MrGaintsquirrel/amplifier/versterker.kicad_pcb

## KiCad design versterker.kicad_pcb (2022-01-10)

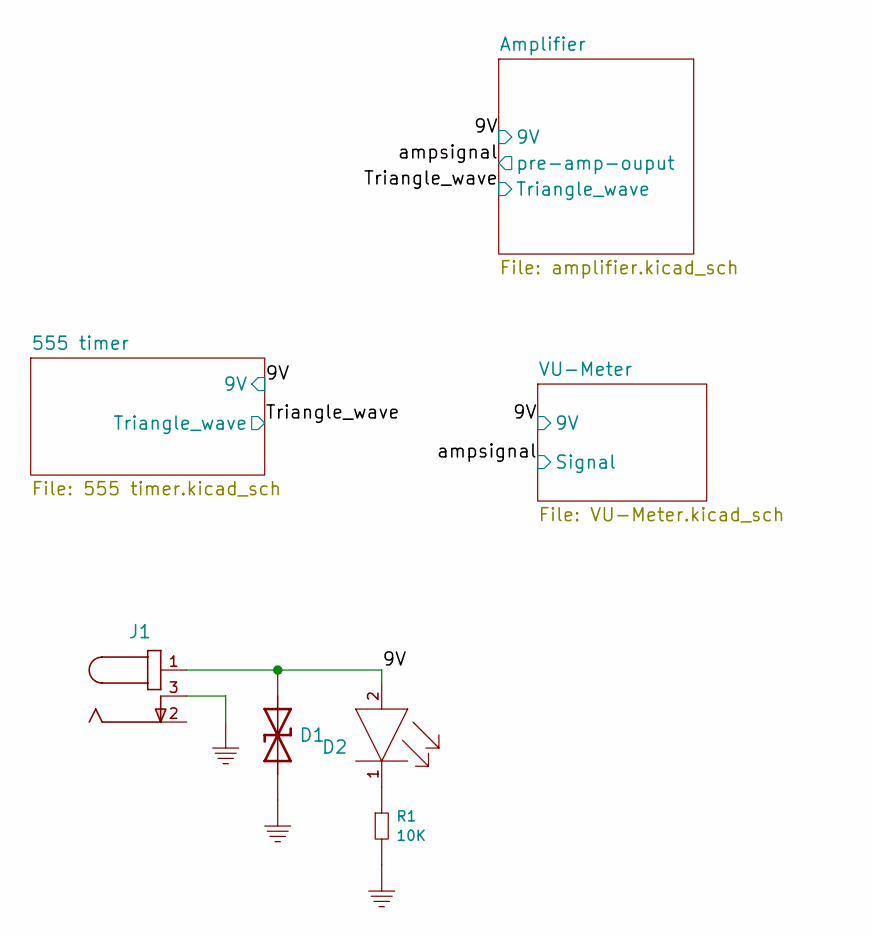
[picture p1: schematic versterker.kicad_sch]

Parts:
D1: D_SMCJ9.0CA_TVS; D_9V_TVS_SMCJ-Q; PARTREV 11/20/15; Mouser 576-SMCJ9.0CA
D2: D_RED_0603_Wurth_150060RS75000; D_RED_0603_Wurth; Mouser 710-150060RS75000
J1: J_Barreljack_3.5mm_Wurth_TH; J_Barreljack_3.5mm_Wurth; Mouser 710-694102303002
R1: R_10K_0603; R_0603; Mouser 667-ERJ-UP3F1002V

Connections:
/9V: D1.1, D2.2 (ANODE), J1.1; also elsewhere on the board
GND: D1.2, J1.3, R1.2; also elsewhere on the board
unnamed: D2.1 (CATHODE), R1.1

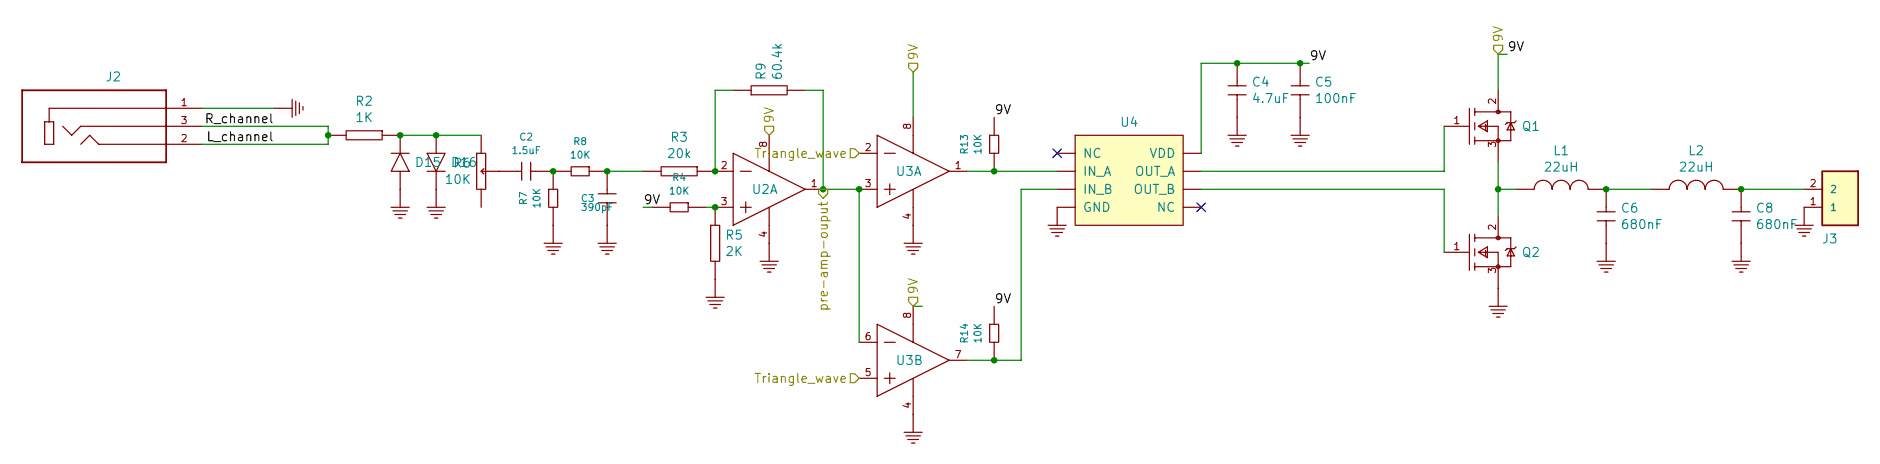
[picture p2: schematic amplifier.kicad_sch]

Parts:
C2: C_1.5uF_0603_25V; C_0603; Mouser 810-C1608X5R1E155K
C3: C_390pF_0603_50V; C_0603; Mouser 80-C0603C391K5R
C4: C_4.7uF_0603_25V; C_0603; Mouser 963-TMK107BBJ475KA-T
C5: C_100nF_0603_25V; C_0603; Mouser 810-C0603X5R1E104KBB
C6, C8: C_680nF_TH_450V; C_ECWFD_Panasonic; Mouser 667-ECW-FD2W684J
D15, D16: D_1N4148WS_SOD323F_ONSEMI; D_1N4148_SOD-323F_ONSEMI; Mouser 512-1N4148WS
J2: J_3.5mm_jack_SJ1-3523N; CUI_SJ1-3523N; Mouser 490-SJ1-3523N
J3: J_2_screwterminal_2.54_282834-2; J_2_screwterminal_2.54; Mouser 571-282834-2
L1, L2: L_22uH_RFS1113_coilcraft_TH; L_RFS1113_coilcraft; Mouser 994-RFS1113-223ME
Q1, Q2: Q_IRFZ44NPBF_N-Channel_Infineon; Q_IRFZ44NPBF_Infineon; Mouser 942-IRFZ44NPBF
R2: R_1K_0603; R_0603; Mouser 667-ERJ-PB3D1001V
R3: R_20K_0603; R_0603; Mouser 603-RT0603FRE0720KL
R4, R7, R8, R13, R14: R_10K_0603; R_0603; Mouser 667-ERJ-UP3F1002V
R5: R_2K_0603; R_0603; Mouser 603-RT0603BRD072KL
R6: R_10K_Potmeter; R_TH_POT_P160series
R9: R_60.4K_0603; R_0603; Mouser 603-RT0603DRE0760K4L
U2: U_LM358AP_TI_DIP; Mouser 926-LM358N/NOPB
U3: U_LM393N_NOPB; U_TI_LM393N_NOPB; Mouser 926-LM393N/NOPB
U4: U_TC4427M_Microchip; U_8_DIP_TC4427CPA_Microchip; Mouser 579-TC4427ACPA

Connections:
/9V: C4.1, C5.1, Q1.2 (DRAIN), R4.2, R13.1, R14.1, U2.8 (VCC), U3.8 (V+), U4.6 (VDD); also elsewhere on the board
/Amplifier/L_channel: J2.2, J2.3, R2.2
/Triangle_wave: U3.2 (INA-), U3.5 (INB+); also elsewhere on the board
/ampsignal: R9.2, U2.1 (1OUT), U3.3 (INA+), U3.6 (INB-); also elsewhere on the board
GND: C3.2, C4.2, C5.2, C6.2, C8.2, D15.A, D16.C, J2.1, J3.1, Q2.3 (SOURCE), R5.2, R7.2, U2.4 (GND), U3.4 (GND), U4.3 (GND); also elsewhere on the board
unnamed: C2.1, R7.1, R8.2
unnamed: C2.2, R6.2 (S)
unnamed: C3.1, R3.2, R8.1
unnamed: C6.1, L1.2, L2.1
unnamed: C8.1, J3.2, L2.2
unnamed: D15.C, D16.A, R2.1, R6.1
unnamed: L1.1, Q1.3 (SOURCE), Q2.2 (DRAIN)
unnamed: Q1.1 (GATE), U4.7 (OUT_A)
unnamed: Q2.1 (GATE), U4.5 (OUT_B)
unnamed: R3.1, R9.1, U2.2 (1IN-)
unnamed: R4.1, R5.1, U2.3 (1IN+)
unnamed: R13.2, U3.1 (OUTA), U4.2 (IN_A)
unnamed: R14.2, U3.7 (OUTB), U4.4 (IN_B)

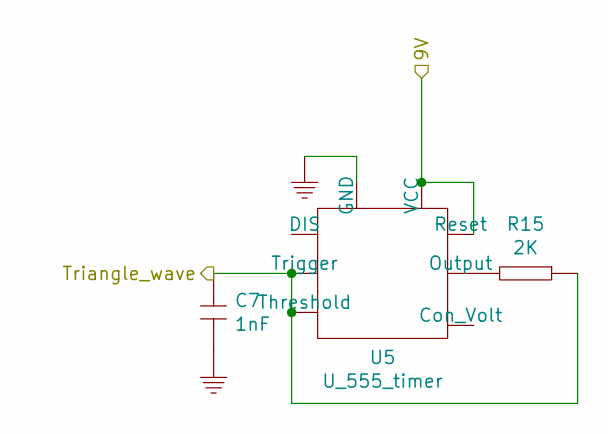
[picture p3: schematic 555 timer.kicad_sch]

Parts:
C7: C_1nF_0603_50V; C_0603; Mouser 603-CC603MRX7R9BB102
R15: R_2K_0603; R_0603; Mouser 603-RT0603BRD072KL
U5: U_555_timer; U_LM555CN

Connections:
/9V: U5.4 (Reset), U5.8 (VCC); also elsewhere on the board
/Triangle_wave: C7.1, R15.1, U5.2 (Trigger), U5.6 (Threshold); also elsewhere on the board
GND: C7.2, U5.1 (GND); also elsewhere on the board
unnamed: R15.2, U5.3 (Output)

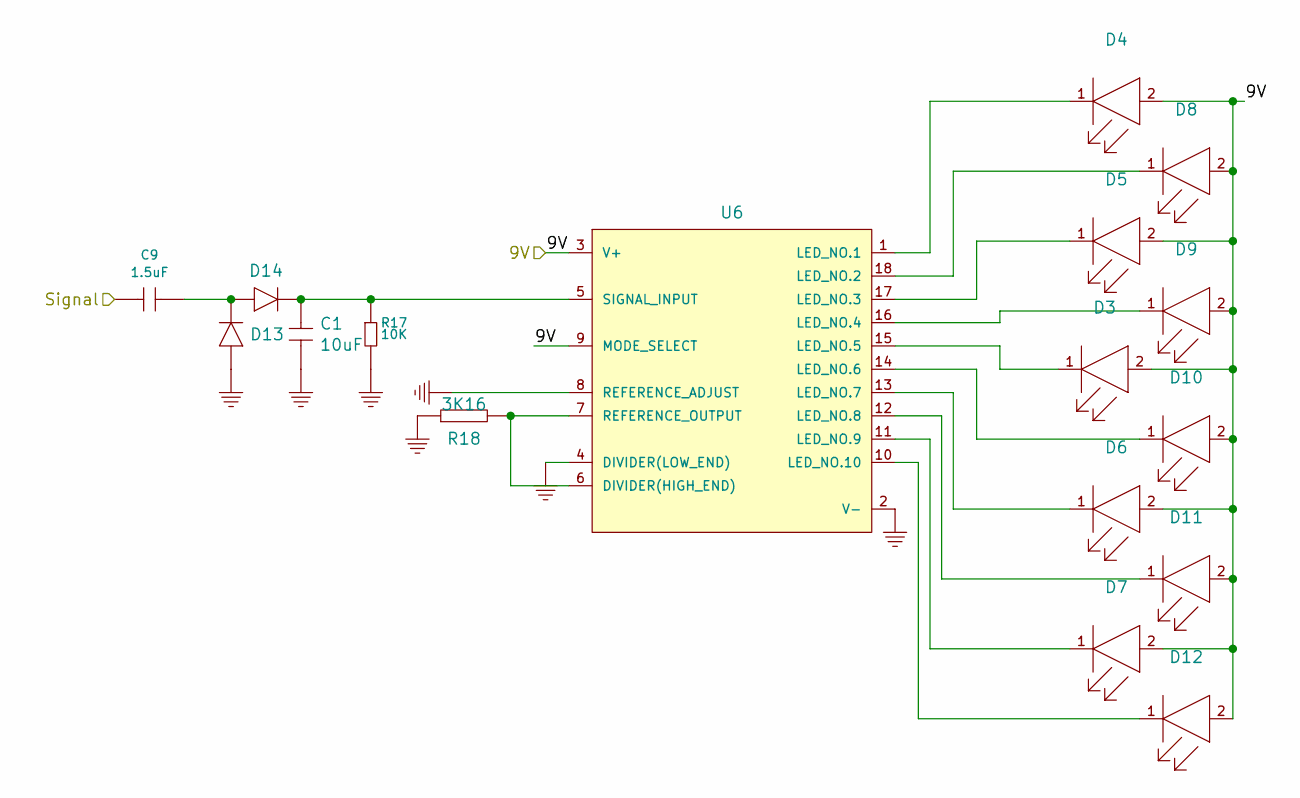
[picture p4: schematic VU-Meter.kicad_sch]

Parts:
C1: C_10uF_0603_16V; C_0603; Mouser 187-CL10A106KO8NQNC
C9: C_1.5uF_0603_25V; C_0603; Mouser 810-C1608X5R1E155K
D3, D4, D5, D6, D7, D8, D9, D10, D11, D12: D_RED_0603_Wurth_150060RS75000; D_RED_0603_Wurth; Mouser 710-150060RS75000
D13, D14: D_1N4148WS_SOD323F_ONSEMI; D_1N4148_SOD-323F_ONSEMI; Mouser 512-1N4148WS
R17: R_10K_0603; R_0603; Digi-key YAG1236CT-ND
R18: R_3K16_0603; R_0603; Mouser 603-RT0603BRD073K16L
U6: U_LM3914N-1_NOPB; U_LM3914_TI_DIP; Mouser 926-LM3914N-1/NOPB

Connections:
/9V: D3.2 (ANODE), D4.2 (ANODE), D5.2 (ANODE), D6.2 (ANODE), D7.2 (ANODE), D8.2 (ANODE), D9.2 (ANODE), D10.2 (ANODE), D11.2 (ANODE), D12.2 (ANODE), U6.3 (V+), U6.9 (MODE_SELECT); also elsewhere on the board
/ampsignal: C9.2; also elsewhere on the board
GND: C1.2, D13.A, R17.2, R18.1, U6.2 (V-), U6.4 (DIVIDER(LOW_END)), U6.8 (REFERENCE_ADJUST); also elsewhere on the board
unnamed: C1.1, D14.C, R17.1, U6.5 (SIGNAL_INPUT)
unnamed: C9.1, D13.C, D14.A
unnamed: D3.1 (CATHODE), U6.15 (LED_NO.5)
unnamed: D4.1 (CATHODE), U6.1 (LED_NO.1)
unnamed: D5.1 (CATHODE), U6.17 (LED_NO.3)
unnamed: D6.1 (CATHODE), U6.13 (LED_NO.7)
unnamed: D7.1 (CATHODE), U6.11 (LED_NO.9)
unnamed: D8.1 (CATHODE), U6.18 (LED_NO.2)
unnamed: D9.1 (CATHODE), U6.16 (LED_NO.4)
unnamed: D10.1 (CATHODE), U6.14 (LED_NO.6)
unnamed: D11.1 (CATHODE), U6.12 (LED_NO.8)
unnamed: D12.1 (CATHODE), U6.10 (LED_NO.10)
unnamed: R18.2, U6.6 (DIVIDER(HIGH_END)), U6.7 (REFERENCE_OUTPUT)

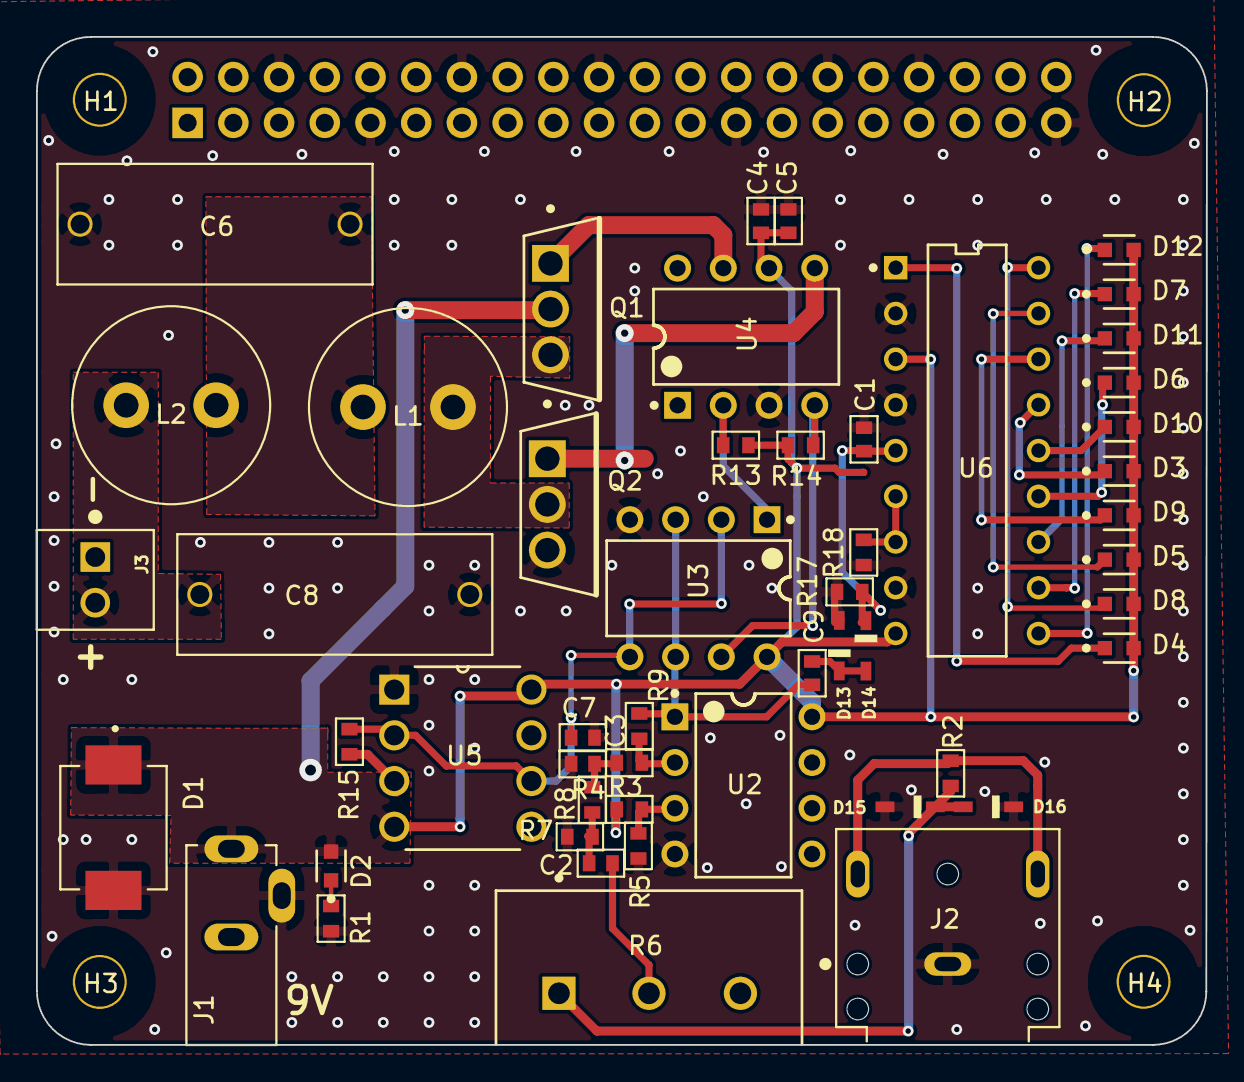
[picture p5: board versterker.kicad_pcb from above]

Board: 2 copper layers, 65.0 x 56.0 mm, 56 parts (1 on the bottom side), 34 nets.

Other parts of the board:
H1, H2, H3, H4: 3mm_Mounting_Hole; NPTH_3mm_ID
J3#2: 40HAT; PinSocket_2x20_P2.54mm_Vertical

Their connections:
/P5V_HAT: J3#2.2, J3#2.4
GND: J3#2.6, J3#2.9, J3#2.14, J3#2.20, J3#2.25, J3#2.30, J3#2.34, J3#2.39; also elsewhere on the board
