MrGaintsquirrel/amplifier/(commit log)

2021-10-14 added mosfet and driver
    [amplifier.sch]
2021-10-18 added bandpass filter
    [amplifier.sch]
2021-10-18 added filter end stage
    [amplifier.sch, versterker.sch]
2021-10-19 created pcb
    [555 timer.sch, PSU.sch, VU-Meter.sch, amplifier.sch, versterker.sch]
2021-11-21 changes made
    [555 timer.sch, PSU.sch, VU-Meter.sch, amplifier.sch, versterker.sch]
2021-11-21 changed vu meter resistor value's
    [555 timer.sch, PSU.sch, VU-Meter.sch, amplifier.sch, versterker.sch]
2021-12-06 added raspberry pi hat pcb outline and layout
    [555 timer.sch, PSU.sch, VU-Meter.sch, amplifier.sch, versterker.kicad_pcb, versterker.sch]
2021-12-06 changed everything to 9V and changed inductor to match one in stock
    [555 timer.sch, VU-Meter.sch, amplifier.sch, versterker.kicad_pcb, versterker.sch]
2021-12-09 changed vu meter circuit
    [VU-Meter.sch, amplifier.sch, versterker.kicad_pcb, versterker.sch]
2021-12-10 routed pcb
    [VU-Meter.sch, amplifier.sch, versterker.kicad_pcb]
2021-12-10 made schematic changed based on testing
    [555 timer.sch, VU-Meter.sch, amplifier.sch, versterker.sch]
2021-12-11 made gerbers
    [versterker.kicad_pcb]
2021-12-17 changed gerbers after receiving pcb
    [versterker.kicad_pcb]
2021-12-18 changed partnumbers
    [VU-Meter.sch, amplifier.sch, versterker.kicad_pcb, versterker.sch, versterker_BOM.csv]
2022-01-10 changed to new kicad6
    [555 timer.kicad_sch, FINALBOM.xlsx, VU-Meter.kicad_sch, amplifier.kicad_sch, versterker.kicad_pcb, versterker.kicad_sch]
